Alexou1209/DEC-Final-Project-Automated-Turret/hardware/Controller/Generate Files/DRC/Controller.html

Reporting Options

# File in Newer Format

Date | : | 5/14/2025
Time | : | 11:36:39 AM
Filename | : | C:\_ecole\_ProjetDECFinal\Altium\KJ_Turret_Command\KJ_Turret_Command.PrjPcb

Version | Warning

Release 23.10

CAUTION - This project contains rules defined using the Constraint Manager. You are seeing this message for two possible reasons. Firstly, this is an older version of the software that does not support this feature, in which case design rules will fall back to being presented as standard, query-based rules. If you save the PCB project in this older version of Altium Designer, all Constraint Manager data structure information will be lost. Secondly, if this software version does support the feature, then you currently don't have the level of Altium Designer Software Subscription (Pro/Enterprise) to be able to edit constraints using the Constraint Manager, in which case it will present rules in view only mode.

This file was generated by a later version of the software
