Alexou1209/DEC-Final-Project-Automated-Turret/hardware/Turret/Generate Files/DRC/Projet_Guimbarde.html

Altium

# Design Rule Verification Report

Date: | | 24/04/2025
Time: | | 12:11:30
Elapsed Time: | | 00:00:02
Filename: | | C:\Users\alexa\Desktop\Projet Final KJ\PCB_AD_Projet_Guimbarde\PCB_Moteurs.PcbDoc

Warnings: | | 0
Rule Violations: | | 0

## Summary

Warnings | Count
Total | 0

Rule Violations | Count
Clearance Constraint (Gap=0.15mm) (All),(All) | 0
Clearance Constraint (Gap=0.5mm) (InPoly),(All) | 0
Short-Circuit Constraint (Allowed=No) (All),(All) | 0
Un-Routed Net Constraint ( (All) ) | 0
Modified Polygon (Allow modified: No), (Allow shelved: No) | 0
Width Constraint (Min=0.15mm) (Max=5mm) (Preferred=0.2mm) (All) | 0
Power Plane Connect Rule(Relief Connect )(Expansion=0.508mm) (Conductor Width=0.254mm) (Air Gap=0.254mm) (Entries=4) (All) | 0
Hole Size Constraint (Min=0.2mm) (Max=5mm) (All) | 0
Hole To Hole Clearance (Gap=0.3mm) (All),(All) | 0
Minimum Solder Mask Sliver (Gap=0.075mm) (All),(All) | 0
Silk To Solder Mask (Clearance=0mm) (IsPad),(All) | 0
Silk to Silk (Clearance=0mm) (All),(All) | 0
Net Antennae (Tolerance=0mm) (All) | 0
Board Clearance Constraint (Gap=0mm) (All) | 0
Height Constraint (Min=0mm) (Max=25.4mm) (Prefered=12.7mm) (All) | 0
Total | 0
