Alexou1209/DEC-Final-Project-Automated-Turret/docs/Photo_videos/Turret_no_legs.jpg

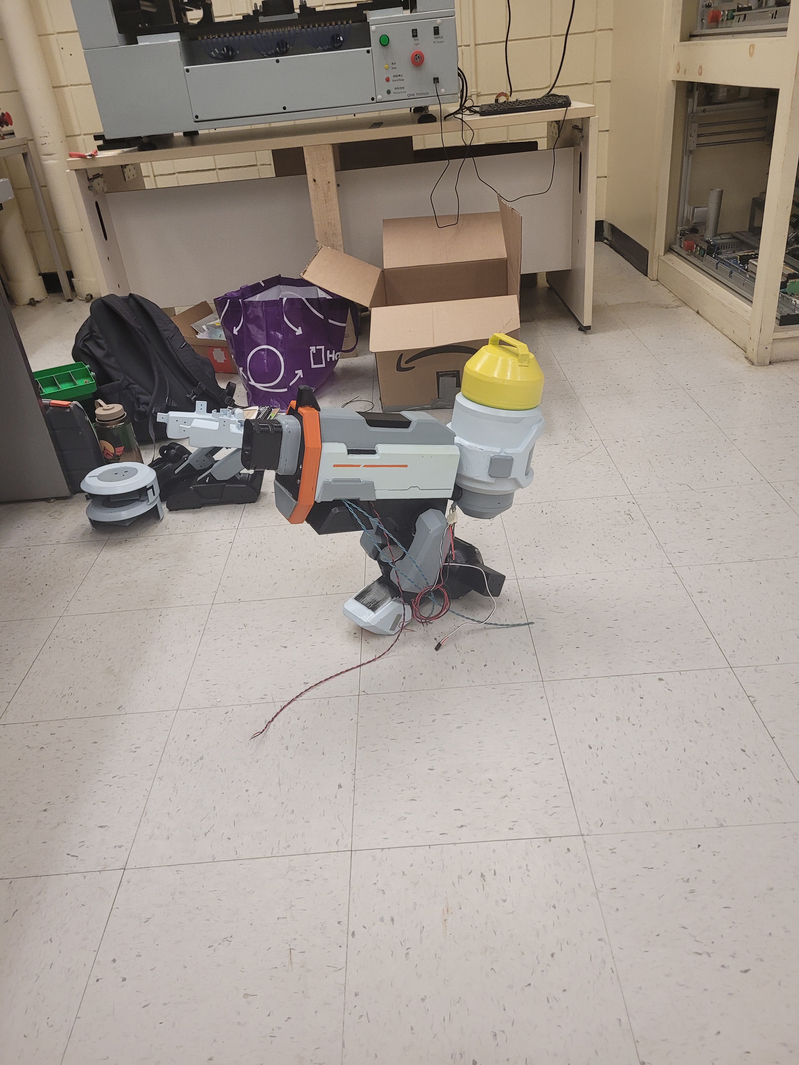
docs/Photo_videos/Turret_no_legs.jpg
