Alexou1209/DEC-Final-Project-Automated-Turret/hardware/Controller/schematic_png/Controller_Accessories.png

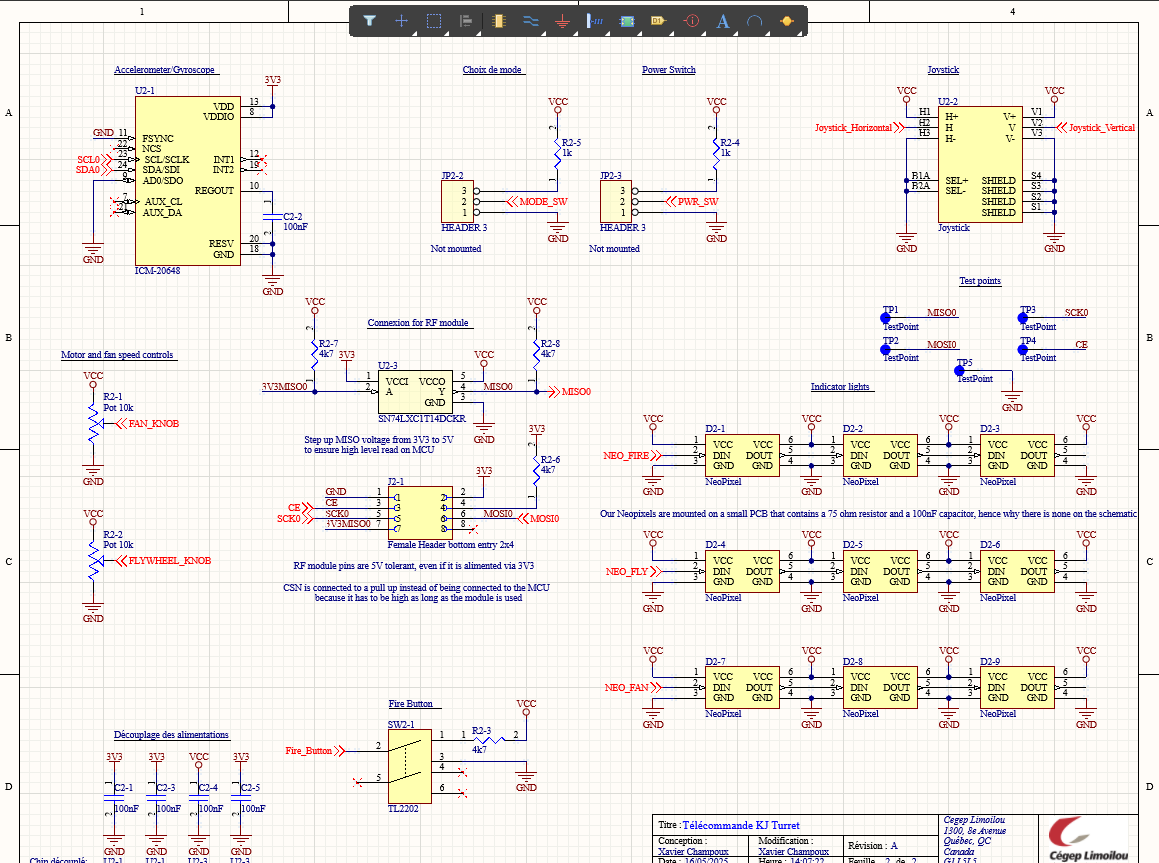
hardware/Controller/schematic_png/Controller_Accessories.png
