Alexou1209/DEC-Final-Project-Automated-Turret/hardware/Controller/schematic_png/Controller_Processing.png

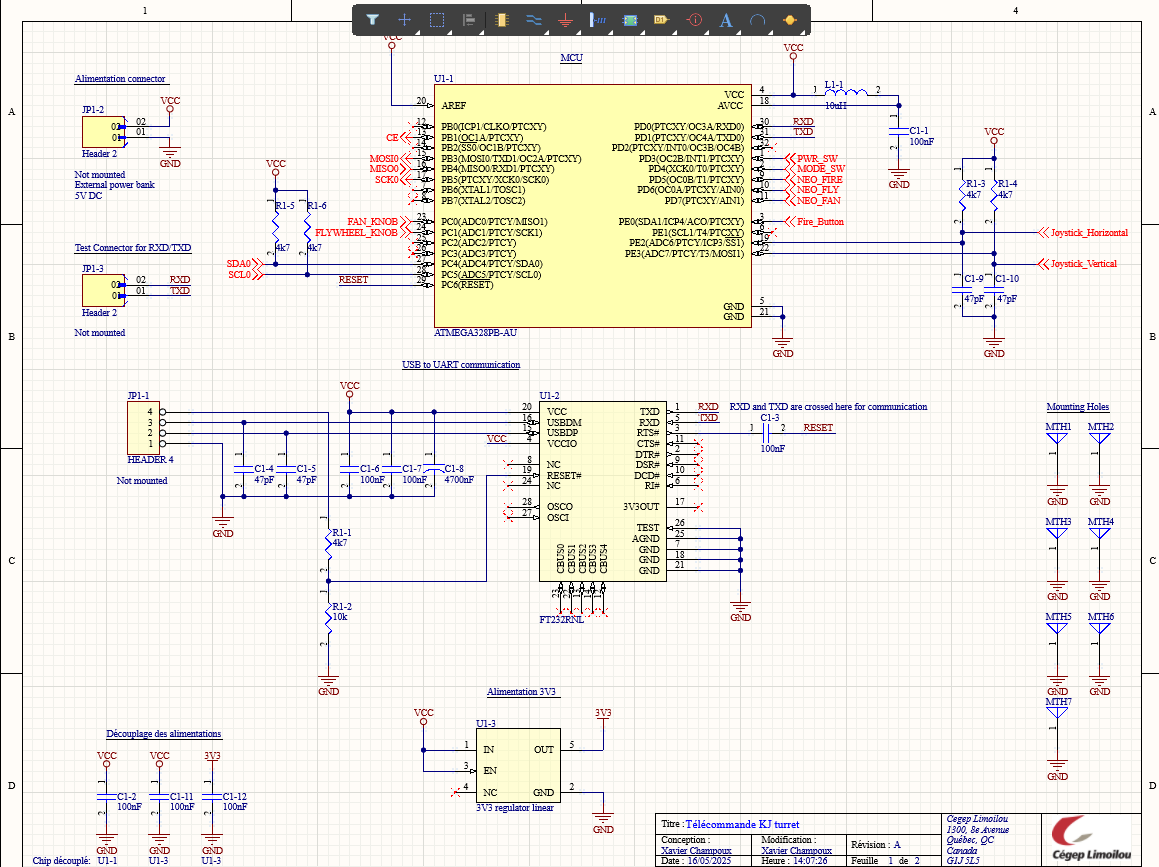
hardware/Controller/schematic_png/Controller_Processing.png
