Alexou1209/DEC-Final-Project-Automated-Turret/hardware/Turret/Schematic_png/Turret_Power.png

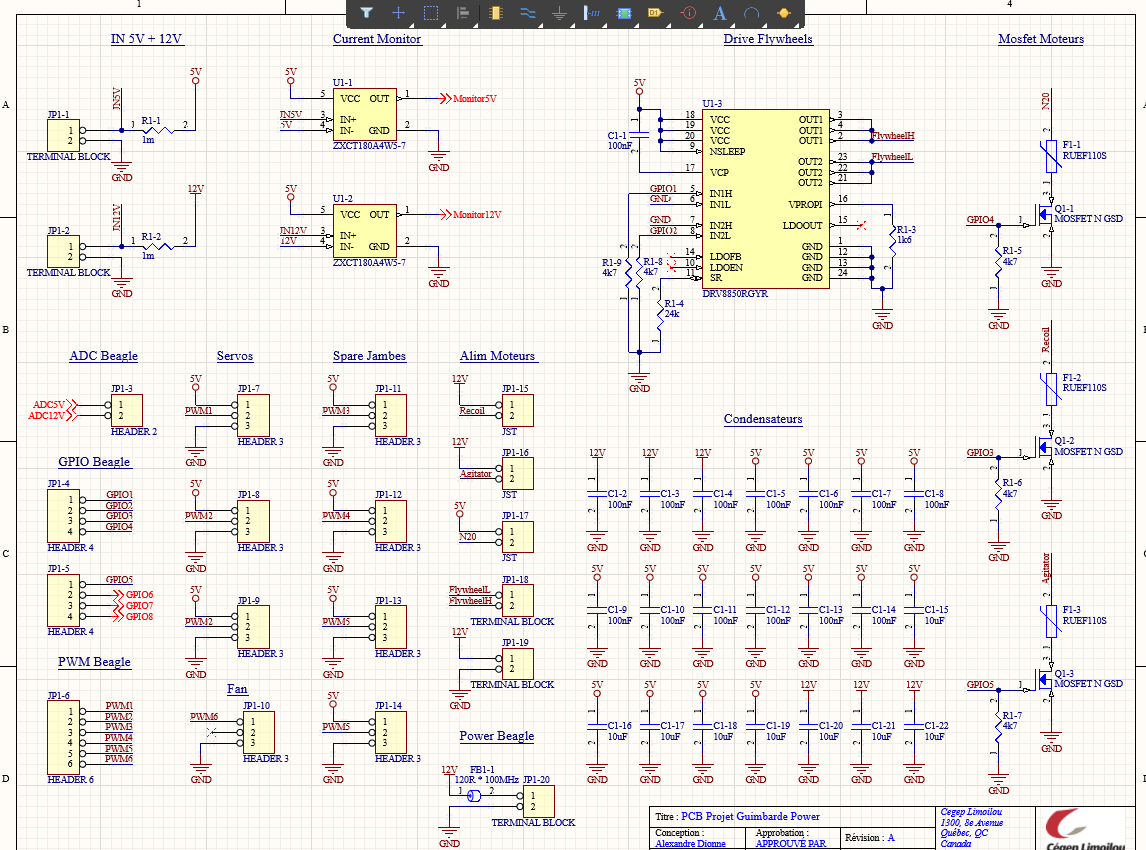
hardware/Turret/Schematic_png/Turret_Power.png
