Alexou1209/DEC-Final-Project-Automated-Turret/hardware/Controller/Generate Files/BOM/Controller.xlsx

LibRef | Designator | Quantity | Manufacturer 1 | Manufacturer Part Number 1 | Supplier 1 | Supplier Unit Price 1 | Supplier Part Number 1 | Purchase-URL
0.1 µF ±10% 100V Ceramic Capacitor 0805 | C1-1, C1-2, C1-3, C1-6, C1-7, C1-11, C1-12, C2-1, C2-2, C2-3, C2-4, C2-5 | 12 | Samsung Electro-Mechanics | CL21B104KCFNNNE | Digikey | 0,12$ | 1276-6840-1-ND | https://www.digikey.ca/en/products/detail/samsung-electro-mechanics/CL21B104KCFNNNE/5961324
0.047 µF ±10% 50V Ceramic Capacitor 0805 | C1-4, C1-5, C1-9, C1-10 | 4 | Samsung Electro-Mechanics | CL21B473KBCNNNC | Digikey | 0,12$ | 1276-1250-1-ND | https://www.digikey.ca/en/products/detail/samsung-electro-mechanics/CL21B473KBCNNNC/3886908
4.7 µF 50 V Aluminum Electrolytic Capacitors Radial | C1-8 | 1 | Würth Elektronik | 860010672008 | Digikey | 0,15$ | 732-8660-1-ND | https://www.digikey.ca/en/products/detail/w%C3%BCrth-elektronik/860010672008/5726907
WS2812B LED Chip 5050 SMD RGB DC5V | D2-1, D2-2, D2-3, D2-4, D2-5, D2-6, D2-7, D2-8, D2-9 | 9 | QINGYING | WS2812B Chip | AliExpress | 2,23$ | non existant | https://www.aliexpress.com/item/32916178393.html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
8 Position Receptacle, Bottom Entry Through Hole Gold | J2-1 | 1 | Amphenol ICC (FCI) | 71991-304LF | Digikey | 1,74$ | 71991-304LF-ND | https://www.digikey.ca/en/products/detail/amphenol-cs-fci/71991-304LF/1524562
10 µH Shielded Multilayer Inductor 500 mA 300mOhm 0805 | L1-1 | 1 | TDK Corporation | MLZ2012N100LT000 | Digikey | 0,16$ | 445-6762-1-ND | https://www.digikey.ca/en/products/detail/tdk-corporation/MLZ2012N100LT000/2523500
4.7 kOhms ±1% 1/8W Chip Resistor 0805 | R1-1, R1-3, R1-4, R1-5, R1-6, R2-3, R2-6, R2-7, R2-8 | 9 | Vishay Dale | CRCW08054K70FKEAC | Digikey | 0,16$ | 541-4131-1-ND | https://www.digikey.ca/en/products/detail/vishay-dale/CRCW08054K70FKEAC/7928553
10 kOhms ±1% 1/8W Chip Resistor 0805 | R1-2 | 1 | Stackpole Electronics Inc | RMCF0805FT10K0 | Digikey | 0,16$ | RMCF0805FT10K0CT-ND | https://www.digikey.ca/en/products/detail/stackpole-electronics-inc/RMCF0805FT10K0/1760676
10k 1 Gang Linear Through Hole Potentiometer 1 Turns 1/20W | R2-1, R2-2 | 2 | Same Sky (Formerly CUI Devices) | PT01-D120K2-B103 | Digikey | 1,36$ | 2223-PT01-D120K2-B103-ND | https://www.digikey.ca/en/products/detail/same-sky-formerly-cui-devices/PT01-D120K2-B103/15903919
1 kOhms ±1% 1/4W Chip Resistor 0805 | R2-4, R2-5 | 2 | Stackpole Electronics Inc | RNCP0805FTD1K00 | Digikey | 0,16$ | RNCP0805FTD1K00CT-ND | https://www.digikey.ca/en/products/detail/stackpole-electronics-inc/RNCP0805FTD1K00/2240229
Pushbutton Switch DPDT Standard Through Hole | SW2-1 | 1 | E-Switch | TL2202EEZB (GRN ACT) | Digikey | 0,68$ | 141-TL2202EEZB(GRNACT)-ND | https://www.digikey.ca/en/products/detail/e-switch/TL2202EEZB-GRN-ACT/16020087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
PC TEST POINT COMPACT BLACK | TP1, TP2, TP3, TP4, TP5 | 5 | Keystone Electronics | 5006 | Digikey | 0,59$ | 36-5006-ND | https://www.digikey.ca/en/products/detail/keystone-electronics/5006/255330
AVR® ATmega (FuSa) Microcontroller IC 8-Bit 20MHz 32KB FLASH 32-TQFP | U1-1 | 1 | Microchip Technology | ATMEGA328PB-AU | Digikey | 2,63$ | ATMEGA328PB-AU-ND | https://www.digikey.ca/en/products/detail/microchip-technology/ATMEGA328PB-AU/5638812
USB 2.0 to UART Interface 28-SSOP | U1-2 | 1 | FTDI, Future Technology Devices International Ltd | FT232RNL-TUBE | Digikey | 7,73$ | 768-FT232RNL-TUBE-ND | https://www.digikey.ca/en/products/detail/ftdi-future-technology-devices-international-ltd/FT232RNL-TUBE/16836164
Linear Voltage Regulator IC Positive Fixed 1 Output 300mA SOT-23-5 | U1-3 | 1 | Texas Instruments | TLV74033PDBVR | Digikey | 0,16$ | 296-TLV74033PDBVRCT-ND | https://www.digikey.ca/en/products/detail/texas-instruments/TLV74033PDBVR/12642183
Accelerometer, Gyroscope, Temperature, 6 Axis I2C, SPI Output | U2-1 | 1 | TDK InvenSense | ICM-20648 | Digikey | 5,64$ | 1428-1061-1-ND | https://www.digikey.ca/en/products/detail/tdk-invensense/icm-20648/5872871
Joystick, 2 - Axis Analog (Resistive) Output | U2-2 | 1 | SparkFun Electronics | COM-09032 | Digikey | 8,44$ | 1568-1526-ND | https://www.digikey.ca/en/products/detail/sparkfun-electronics/COM-09032/6823623
Voltage Level Translator Unidirectional 1 Circuit 1 Channel 420Mbps SC-70-5 | U2-3 | 1 | Texas Instruments | SN74LXC1T14DCKR | Digikey | 0,40$ | 296-SN74LXC1T14DCKRCT-ND | https://www.digikey.ca/en/products/detail/texas-instruments/SN74LXC1T14DCKR/16585641
