Alexou1209/DEC-Final-Project-Automated-Turret/hardware/Turret/Generate Files/BOM/Projet_Guimbarde.xlsx

LibRef | Comment | Manufacturer | Quantity | Description | Designator | Footprint | Supplier 1 | Supplier Part Number 1 | Manufacturer2_PN | Manufacturer2 | Manufacturer3_PN | Manufacturer3 | PartType
CAP NP | 100nF |  | 19 |  | C1-1, C1-2, C1-3, C1-4, C1-5, C1-6, C1-7, C1-8, C1-9, C1-10, C1-11, C1-12, C1-13, C1-14, C3-1, C3-2, C3-3, C3-4, C3-5 | CAP_0603 |  |  |  |  |  |  | 100nF
CAP NP | 10uF |  | 8 |  | C1-15, C1-16, C1-17, C1-18, C1-19, C1-20, C1-21, C1-22 | CAP_0603 |  |  |  |  |  |  | 10uF
CAP NP | 3.3uF |  | 2 |  | C2-1, C2-2 | CAP_0603 |  |  |  |  |  |  | 3.3uF
DIODE | DIODE |  | 6 |  | D2-1, D2-2, D2-3, D2-4, D2-5, D2-6 | CD214A-B160R |  |  |  |  |  |  | DIODE
LTS-315AHR | LTS-315AHR |  | 4 |  | D3-1, D3-2, D3-3, D3-4 | LTS-315AHR |  |  |  |  |  |  | LTS-315AHR
Polyswitch | RUEF110S |  | 3 |  | F1-1, F1-2, F1-3 | MINISMDC110F/24-2 |  |  |  |  |  |  | RUEF110S
Ferrite | 120R * 100MHz |  | 1 |  | FB1-1 | MFBM1V3216-121-R |  |  |  |  |  |  | 120R * 100MHz
HEADER 2 | TERMINAL BLOCK |  | 6 |  | JP1-1, JP1-2, JP1-18, JP1-19, JP1-20, JP3-1 | TB005-762-02BE |  |  |  |  |  |  | TERMINAL BLOCK
HEADER 2 | HEADER 2 |  | 1 |  | JP1-3 | Header_2 |  |  |  |  |  |  | HEADER 2
HEADER 4 | HEADER 4 |  | 4 |  | JP1-4, JP1-5, JP3-2, JP3-5 | Header_4 |  |  |  |  |  |  | HEADER 4
HEADER 6 | HEADER 6 |  | 2 |  | JP1-6, JP3-3 | Header_6 |  |  |  |  |  |  | HEADER 6
HEADER 3 | HEADER 3 |  | 8 |  | JP1-7, JP1-8, JP1-9, JP1-10, JP1-11, JP1-12, JP1-13, JP1-14 | Header_3 |  |  |  |  |  |  | HEADER 3
HEADER 2 | JST |  | 3 |  | JP1-15, JP1-16, JP1-17 | B2B-PH-K-S |  |  |  |  |  |  | JST
HEADER 4X2 | HEADER 4X2 |  | 1 |  | JP3-4 | Header_2x4 |  |  |  |  |  |  | HEADER 4X2
MOSFET N GSD | MOSFET N GSD |  | 3 |  | Q1-1, Q1-2, Q1-3 | GSFC2312 |  |  |  |  |  |  | MOSFET N GSD
R | 1m |  | 2 |  | R1-1, R1-2 | RES_1206 |  |  |  |  |  |  | 1m
R | 1k6 |  | 1 |  | R1-3 | RES_0603 |  |  |  |  |  |  | 1k6
R | 24k |  | 1 |  | R1-4 | RES_0603 |  |  |  |  |  |  | 24k
R | 4k7 |  | 9 |  | R1-5, R1-6, R1-7, R1-8, R1-9, R3-1, R3-2, R3-3, R3-4 | RES_0603 |  |  |  |  |  |  | 4k7
R | 1k |  | 2 |  | R2-1, R2-2 | RES_0603 |  |  |  |  |  |  | 1k
SW DIP-3 | SW DIP-3 |  | 1 |  | S3-1 | 219-3LPST |  |  |  |  |  |  | SW DIP-3
Test_Point | 5006 |  | 8 |  | TP2-1, TP2-2, TP3-1, TP3-2, TP3-3, TP3-4, TP3-5, TP3-6 | TestPoint |  |  |  |  |  |  | 5006
ZXCT180A4W5-7 | ZXCT180A4W5-7 |  | 2 |  | U1-1, U1-2 | ZXCT180A4W5-7 |  |  |  |  |  |  | ZXCT180A4W5-7
DRV8850RGYR | DRV8850RGYR |  | 1 | No Description Available | U1-3 | DRV8850 |  |  |  |  |  |  | DRV8850RGYR
TCA9406 | TCA9406 |  | 1 |  | U3-1 | TCA9406 |  |  |  |  |  |  | TCA9406
ET6226M | ET6226M |  | 1 |  | U3-2 | ET6226M |  |  |  |  |  |  | ET6226M
