Alexou1209/DEC-Final-Project-Automated-Turret/3d_models/Fan.stl

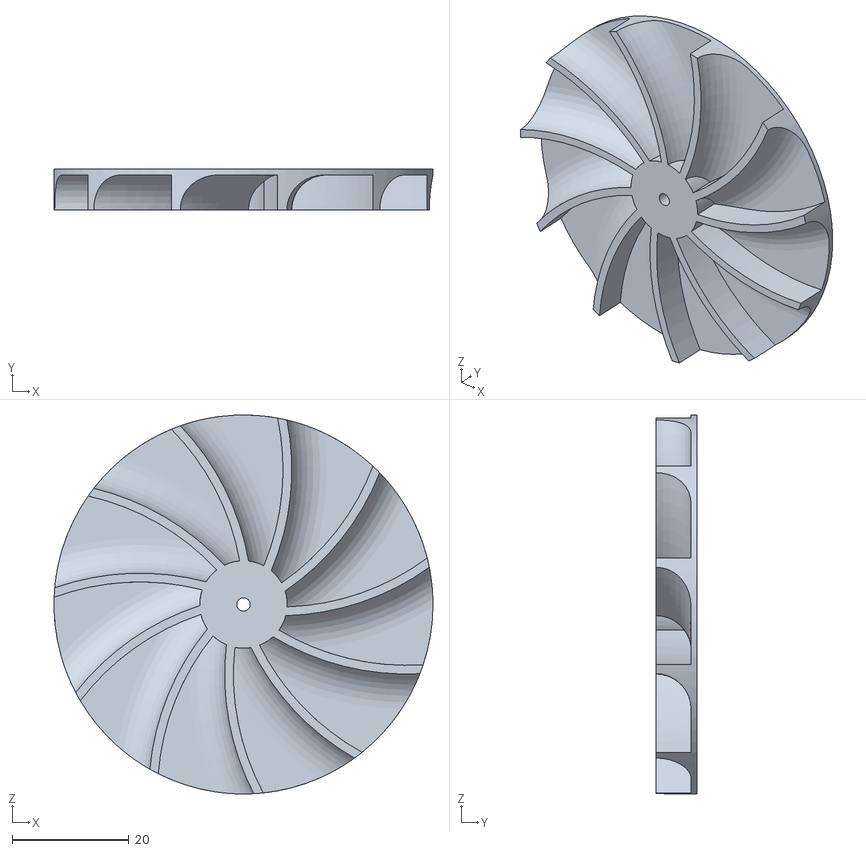
[picture p11: CAD file, 2026-10-25]
3d_models/Fan.stl
65.0 x 7.00 x 65.0
