Alexou1209/DEC-Final-Project-Automated-Turret/hardware/Controller/Generate Files/ExportSTEP/Controller.step

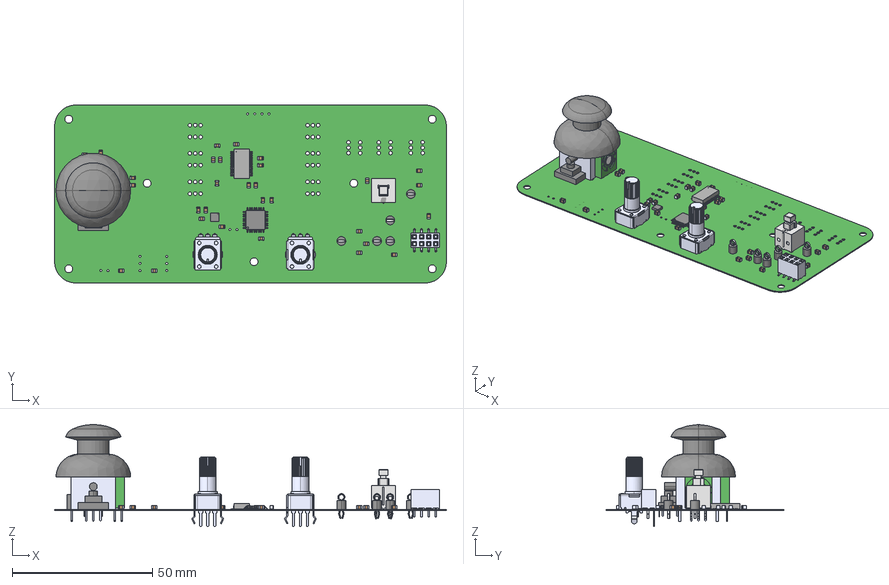
[picture p12: CAD file, 2026-10-25]
hardware/Controller/Generate Files/ExportSTEP/Controller.step
139.7 x 63.5 x 36.4 mm
COM-09032
TL2202OAYB
ICM-20648
PT01_20K2_SHAFT x 2
PT01-D_BODY x 2
PT01-D_SHELL x 2
HeaderBottom_v1
