Alexou1209/DEC-Final-Project-Automated-Turret/hardware/Turret/Generate Files/ExportSTEP/Projet_Guimbarde.step

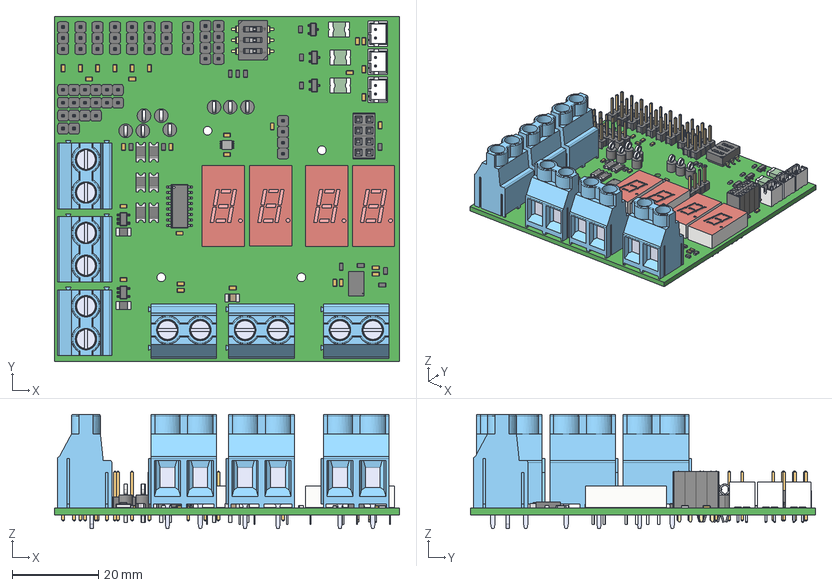
[picture p13: CAD file, 2026-10-25]
hardware/Turret/Generate Files/ExportSTEP/Projet_Guimbarde.step
80.0 x 80.0 x 26.5 mm
Mid_Body x 15
Open_CASCADE_STEP_translator_6.8_8.2.1 x 26
Mark x 15
Open_CASCADE_STEP_translator_6.8_23.1
Open_CASCADE_STEP_translator_6.8_23.2.1
Leader x 35
Open_CASCADE_STEP_translator_6.8_2.1.1 x 2
DIP_3
Open_CASCADE_STEP_translator_6.8_10.2.1 x 4
Open_CASCADE_STEP_translator_6.8_11.1.1 x 3
6130xx11121_PIN x 15
NPPC202LFBN-RC_C04
Pin_-_Gold x 4
TB005-762-02P_Blue_-_S x 6
B2B-PH-K-S x 3
Polyswitch1.1A x 3
Sept_Segments_v1 x 4
Open_CASCADE_STEP_translator_6.8_9.1.1 x 29
Open_CASCADE_STEP_translator_6.8_9.1.2 x 29
Open_CASCADE_STEP_translator_6.8_9.2.1 x 29
