Alexou1209/DEC-Final-Project-Automated-Turret/3d_models/Canister_Bottom.3mf

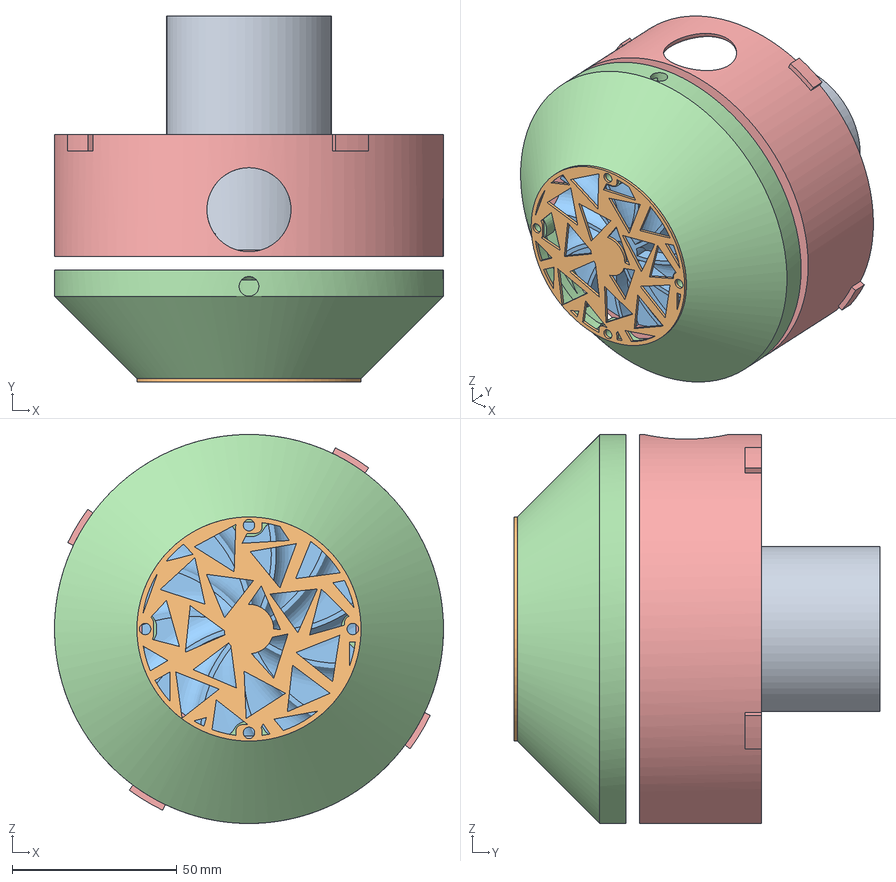
[picture p14: CAD file, 2026-10-25]
3d_models/Canister_Bottom.3mf
118.0 x 111.0 x 118.0 mm
Corps96
Fan Grill
Fan2
Proton Pack Bottom
Proton Pack Top
