Alexou1209/DEC-Final-Project-Automated-Turret/3d_models/PSU_Casing.stl

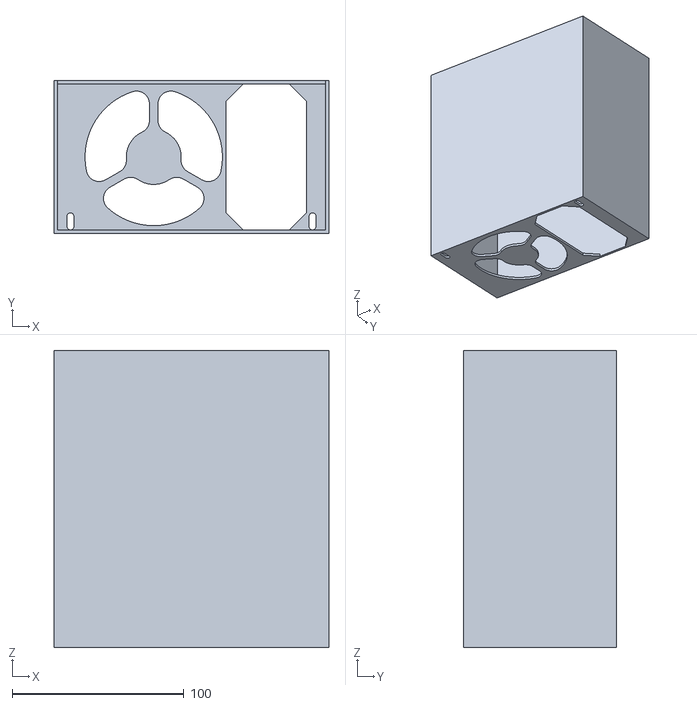
[picture p15: CAD file, 2026-10-25]
3d_models/PSU_Casing.stl
160.0 x 89.0 x 173.0
