Alexou1209/DEC-Final-Project-Automated-Turret/3d_models/Agitator.stl

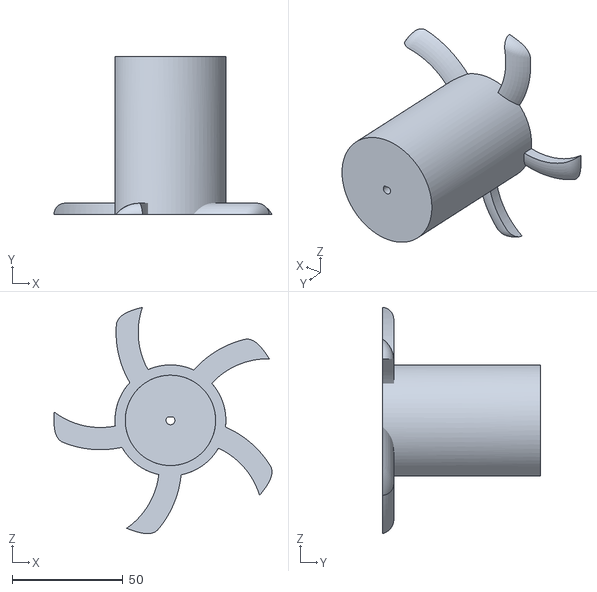
[picture p16: CAD file, 2026-10-25]
3d_models/Agitator.stl
98.3 x 71.0 x 102.0
