Alexou1209/DEC-Final-Project-Automated-Turret/3d_models/Controller_Case.3mf

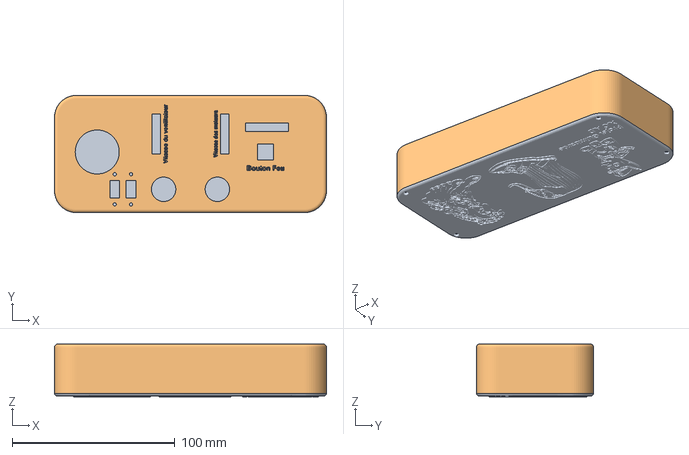
[picture p17: CAD file, 2026-10-25]
3d_models/Controller_Case.3mf
167.0 x 72.0 x 32.5 mm
Case_Bot
Case_Top
