Alexou1209/DEC-Final-Project-Automated-Turret/3d_models/FlyWheel_Bracket.3mf

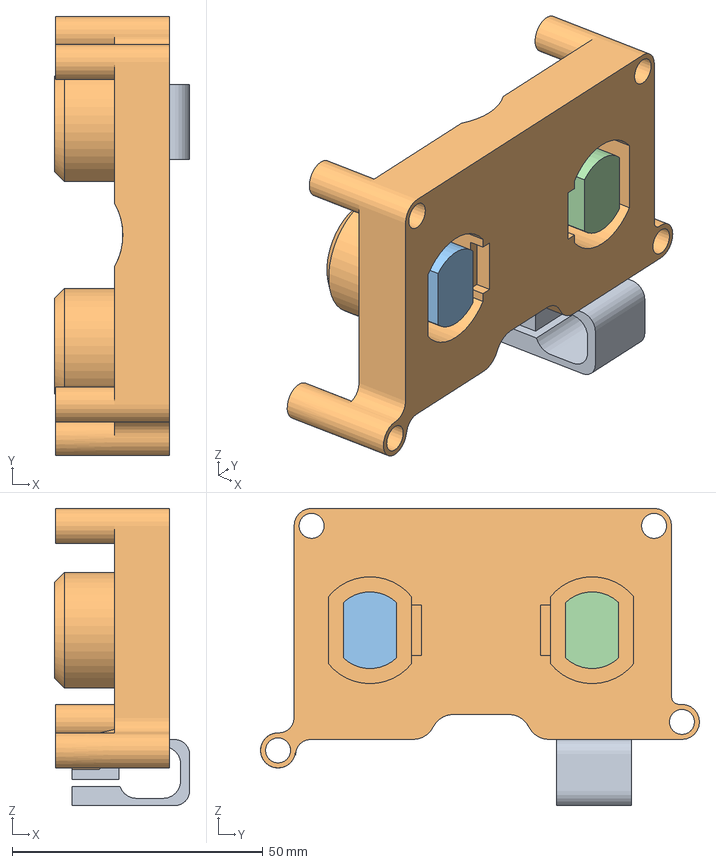
[picture p18: CAD file, 2026-10-25]
3d_models/FlyWheel_Bracket.3mf
27.0 x 87.5 x 59.3 mm
Bracket N20
PlaqueMoteur
Support Plaque Moteur Copy
Support Plaque Moteur
