Alexou1209/DEC-Final-Project-Automated-Turret/(list of files, drawings)

Other design files:
hardware/Controller/Controller.PcbDoc
hardware/Controller/Controller_Accessories.SchDoc
hardware/Controller/Controller_Processing.SchDoc
hardware/Controller/KJ_Turret_Command.PrjPcb
hardware/Turret/Turret.PcbDoc
hardware/Turret/Turret_ADC_Protection.SchDoc
hardware/Turret/Turret_Logic.SchDoc
hardware/Turret/Turret_PCB.PrjPcb
hardware/Turret/Turret_Power.SchDoc
