Alexou1209/DEC-Final-Project-Automated-Turret/(commit log)

2026-10-25 Initial release
    [Agitator.stl, Canister_Bottom.3mf, Controller.PcbDoc, Controller.step, Controller.xlsx, Controller_Accessories.SchDoc, Controller_Case.3mf, Controller_Processing.SchDoc]
2026-10-25 added docs folder
    [Controller.xlsx, Projet_Guimbarde.xlsx]
2026-10-25 Removed root folder
    [Agitator.stl, Canister_Bottom.3mf, Controller.PcbDoc, Controller.step, Controller.xlsx, Controller_Accessories.SchDoc, Controller_Case.3mf, Controller_Processing.SchDoc]
