Alexou1209/DEC-Final-Project-Automated-Turret/docs/Photo_videos/Paint.jpg

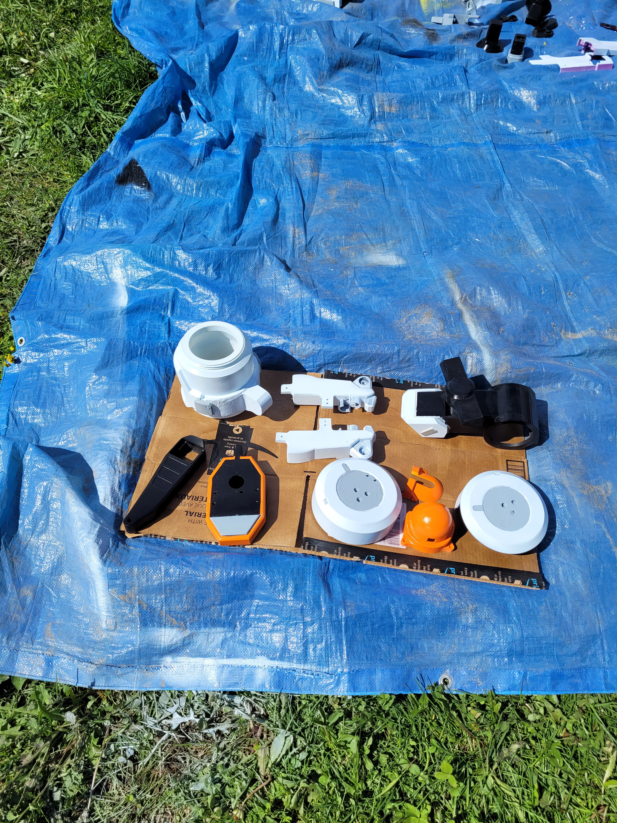
docs/Photo_videos/Paint.jpg
