Alexou1209/DEC-Final-Project-Automated-Turret/docs/Photo_videos/Turret_Final.jpg

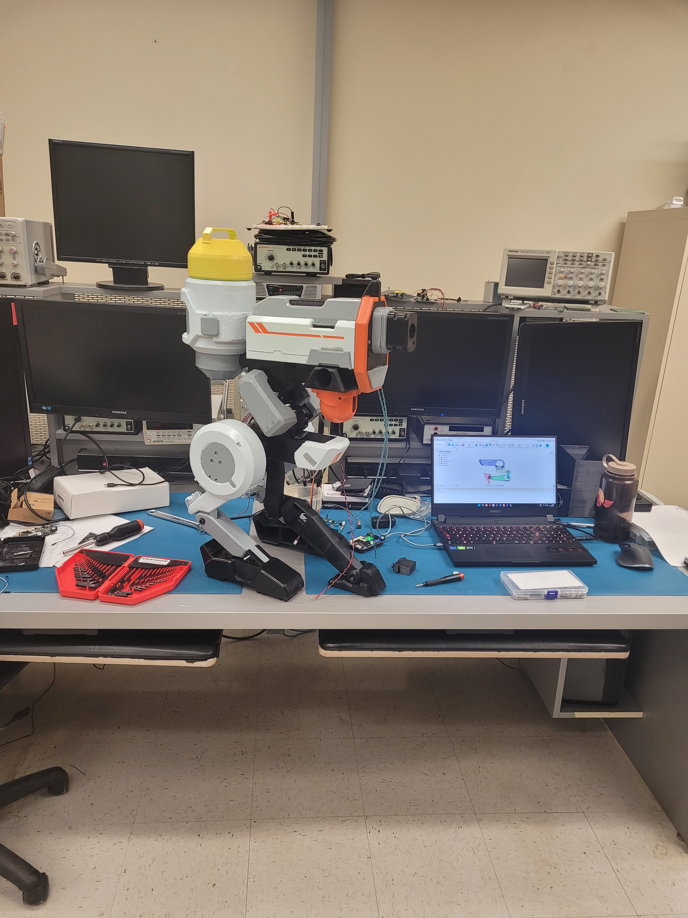
docs/Photo_videos/Turret_Final.jpg
